aChiem85/TPR-FIles/Martin/TPR/Sensor Test Data/Sensor Data Screenshots/car present graph2.JPG

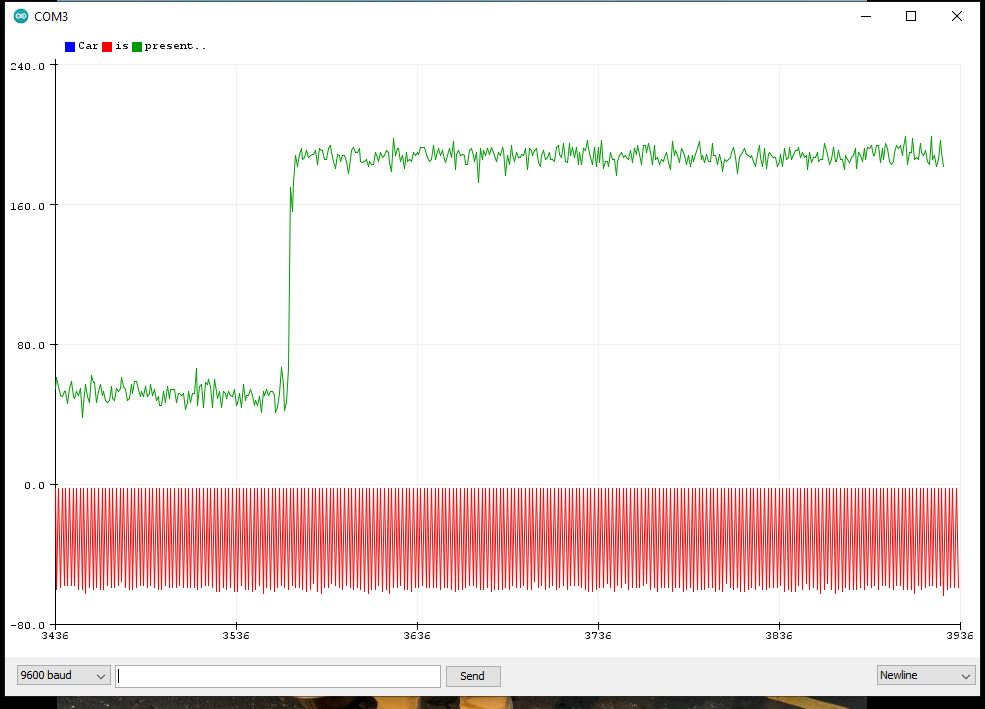
Martin/TPR/Sensor Test Data/Sensor Data Screenshots/car present graph2.JPG
