aChiem85/TPR-FIles/Martin/TPR/Sensor Test Data/Sensor Data Screenshots/car driving in and out.JPG

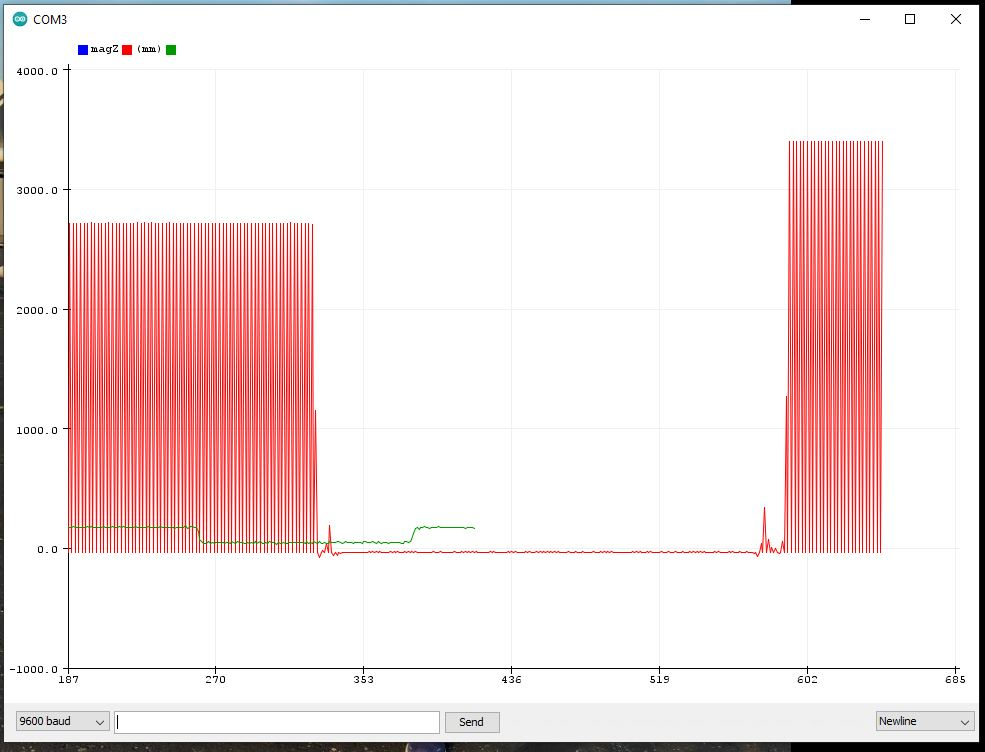
Martin/TPR/Sensor Test Data/Sensor Data Screenshots/car driving in and out.JPG
