aChiem85/TPR-FIles/README.md

# TPR-Files
Senior Design 2 Team Peer Review Files
This is where all documents used for our Senior Design reside.
For all documents dating after the TPR it is in the After TPR Files Directory.
https://github.com/aChiem85/After-TPR-Files
