aChiem85/TPR-FIles/Avery/Research (Technical Journal)/Senior design Arduino config.docx

Senior design Arduino config (Live mobile email dump)

Low power programs

https://www.arduino.cc/en/Reference/ArduinoLowPower

Power supply

https://support.arduino.cc/hc/en-us/articles/360014653660-What-type-of-power-supply-should-I-use-with-my-Arduino-MKR-board-

Support batteries for future application

https://store-usa.arduino.cc/products/arduino-mkr-wan-1310?selectedStore=us

Getting started

https://www.arduino.cc/en/Guide/MKRWAN1310

https://media.digikey.com/pdf/Data%20Sheets/Arduino%20PDFs/ABX00017_1-10-18.pdf

Lora antenna

https://content.arduino.cc/assets/mkrwan1310-murata_lora_module-type_abz.pdf

Sending signal

https://how2electronics.com/sending-sensor-data-lora-sx1278-arduino/

IoT- internet of things


Sent from my iPhone
