aChiem85/TPR-FIles/Midterm Presentation Content.docx

Presentation Content

1. What kind of sensors and electrical components are we going to use and why? (How will it be configured, maybe include price of components?)
2. How will our sensors and hardware work to collect and send data? (what kind of data will the sensors send… unique identifier, Boolean logic for parking stall status, etc.)
3. What is the amount of power consumed by our sensors in accordance with time?
4. How do we plan to power our sensors (battery + solar panel, longevity of charge)?
5. Specifications of electrical equipment such as temperature ranges, detection ranges, transmission ranges, signal speed. (This is a hard bullet to answer as we have not begin testing our equipment)
6. LoRa specification compliance (V1.1 Lora alliance OTAA) provided by coach Allen as a requirement to have information on.
7. How do we plan to mitigate extreme weather and poor conditions such as oil build up, false detection from other metal objects (under ground installation, insulated housing for electrical equipment, NEMA rating needed to satisfy sensor protection, minimum detection time of ferrous object to send signal)
8. Future scope of project and concerns such as mass installation of sensors and easy maintenance or replacement. (this last bullet can be removed as the 7th bullet has lots of content and we may not be able to actually speak to the long term based off of our research this far)

Midterm Presentation and Requirements Review, Conducted Week 7-8: Each team member will be required to equally contribute to the presentation, clearly define their personal contributions towards requirements research, and address questions asked during the review*. The presentation is a summary of the findings

based on the project research conducted. An individual grade is assigned based upon the student’s contribution to the project and oral presentation skills. Each team member is required to present their own research efforts. Each team is required to produce a PowerPoint presentation to clearly and concisely present their requirements research to the class.

The presentation slides will be graded according to the following Rubric:

· Identifies Team Members, Team Structure, Disciplines, and Roles (10%)

· Content Clarity of Presentation Material (organized, summarizes findings) (20%)

· Participation Time of each Presenter (roughly equal) (10%)

The oral presentation will be graded according to the following Rubric:

· Presentation Clarity (simple language, easy to follow narrative) (20%)

· Personal Contributions Identified (and purpose of activity) (20%)

· Presentation Delivery (eye contact, gestures, practiced) (20%)

*Please note: All team members shall be present at midterm presentations
