aChiem85/TPR-FIles/Max/SDP1_BlockDiagram.docx

User Interface (work in progress)

Smart Park Sensor

Battery

Time of Flight Sensor

Magnetometer

Arduino Unit
