aChiem85/TPR-FIles/Alex/Researching Docs/10_08_2021 Researching.odt

Start 12:59 @ 10/08/2021

After the presentation, some things were asked from the instructor:

Power issues

(May be more of a need to get it running basis to know)

Hardware going haywire

(This may be a software thing where conditions can be added)

Sensor(s) performance

(Mentioned the ToF accuracy chart, but was only able to give him an anecdote on the magnetometer’s detection range)

Vehicle Outliers

(We’ve had thoughts on it, but not prepared to answer that yet)

Sensor Spamming

(This may be a conditional thing we can write in the software)

Someone to get in touch for Service Learning: WSU PD

Reasoning

(This could be for handicap spots and be used as a traffic counter. While I still can’t comprehend the traffic counter, I’m sure if I heard it again it would sit better in my mind.)

Reasoning for the group

This could help drop the difficulty a bit and really concentrate on the basics of the hardware package and the software not needing to create more conditions for more outlier situations.

The traffic counter could be a good start use in terms of testing the send/receive frequency and this would test the power consumption of the package rather than the power needed for sending/receiving the payload instead.

END 13:17
