aChiem85/TPR-FIles/Alex/Researching Docs/10_28_2021 Researching.odt

Start 10/28/2021 @ 22:30

Received the Time of Flight Sensor and started to mess with it a bit and various clear covers. It looks like we need to start a calibration to offset the material used. It also wanted very specific requirements. The requirements are:

- A clear cover (glass or plastic is fine, but is more ideal if it didn’t ‘change’).
- The air gap can be 0.5mm AT MOST.
- The cover MUST be parallel to the sensor

It does have it’s own calibration whenever it it power cycles without any additional programming, but it seems we may need to look a bit more deep into starting the calibration to ensure it is reading properly. While I’ve tested both plastic and glass, I do not have a piece of plastic that meets the airgap requirements, but I did manage to find a small piece of clear glass for smartphone cameras and was able to confirm that it does indeed work as intended, but there is some signal loss (mainly losing distance fidelity). The fidelity lost doesn’t seem too much of a drop, as it can still read a white piece of paper pointing at a popcorn ceiling reliably at 30 inches, but gets a bit noisy beyond 30 inches and loses ‘sight’ and very noisy at 40 inches.

END 23:10
