aChiem85/TPR-FIles/Alex/Researching Docs/9_19_2021 Researching.docx

START
Sunday 9/19/2021 @ 10:30AM

Infrared Sensors for Parking

Reference on differing types (Magnetometer, IR, ultrasonic, and radar)

https://hk.element14.com/smart-parking-solutions-the-iot-sensors-space-race

https://ops.fhwa.dot.gov/publications/fhwahop06006/chapter_6.htm

Since we are going for magnetometer

Sensor I found is

# TLV493DA1B6HTSA2

DATASHEET

https://media.digikey.com/pdf/Data%20Sheets/Infineon%20PDFs/TLV493D-A1B6_Rev1.1_4-9-19.pdf

Infineon 3 axis sensor

https://www.digikey.com/en/products/detail/infineon-technologies/TLV493DA1B6HTSA2/5891933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

Pricing tier

1 for $2.11

1000 for $0.88/per

To make it match up

# KITXMC2GOXMC1100V1TOBO1

Infineon dev board with XMC1100 chip on board (recommended in their datasheet)

https://www.digikey.com/en/products/detail/infineon-technologies/KITXMC2GOXMC1100V1TOBO1/4832815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

1 for $6.38

This uses UART communications

UART, or universal asynchronous receiver-transmitter

Make sure ALL components can take the weather swings

Looked into a RAK4200 eval board and breakout board
-40C = -40F

105C = 221F

https://www.thethingsnetwork.org/docs/lorawan/frequencies-by-country/

Need to make sure that we are getting the right frequencies for the US

United States of America (USA) | US902-928

Used in USA, Canada and South America

Uplink:

1. 903.9 - SF7BW125 to SF10BW125
2. 904.1 - SF7BW125 to SF10BW125
3. 904.3 - SF7BW125 to SF10BW125
4. 904.5 - SF7BW125 to SF10BW125
5. 904.7 - SF7BW125 to SF10BW125
6. 904.9 - SF7BW125 to SF10BW125
7. 905.1 - SF7BW125 to SF10BW125
8. 905.3 - SF7BW125 to SF10BW125
9. 904.6 - SF8BW500

Downlink:

1. 923.3 - SF7BW500 to SF12BW500 (RX1)
2. 923.9 - SF7BW500 to SF12BW500 (RX1)
3. 924.5 - SF7BW500 to SF12BW500 (RX1)
4. 925.1 - SF7BW500 to SF12BW500 (RX1)
5. 925.7 - SF7BW500 to SF12BW500 (RX1)
6. 926.3 - SF7BW500 to SF12BW500 (RX1)
7. 926.9 - SF7BW500 to SF12BW500 (RX1)
8. 927.5 - SF7BW500 to SF12BW500 (RX1)
9. 923.3 - SF12BW500 (RX2)

https://www.thethingsnetwork.org/docs/lorawan/limitations/

Need to understand any limitations with LoRa WAN that COULD make it a bit more cumbersome (like the not-real-time data).

Question now: Is purchasing a ‘pre made’ package a good idea? This will probably depend on the CS team in how they want to manage the app and data.

How the duty cycle will affect our sending/receiving to/from sensors to server.

https://www.thethingsnetwork.org/docs/lorawan/duty-cycle/

Modulation and Data Rate

https://www.thethingsnetwork.org/docs/lorawan/modulation-data-rate/

Glance thought: Having these modules on the light posts to mitigate time loss, data/package loss, and the ability to send more data, and use less power on each LoRa WAN module.

LoRa WAN Modules

https://www.google.com/search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

END

Sunday 9/19/2021 11:59am
