aChiem85/TPR-FIles/Alex/ToF Sensor/Window Recommendations.JPG

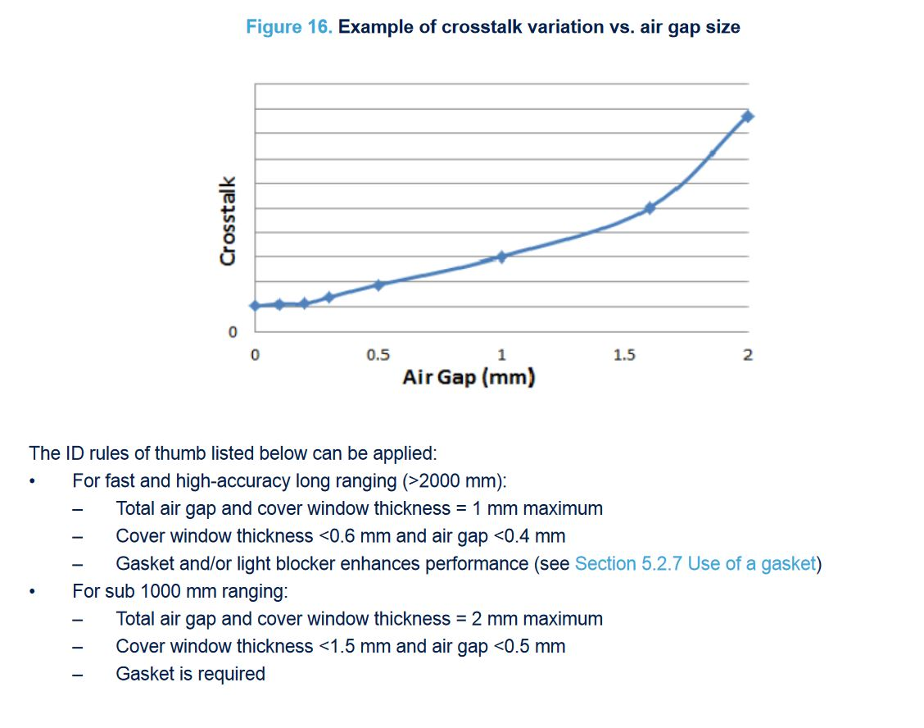
Alex/ToF Sensor/Window Recommendations.JPG
