aChiem85/TPR-FIles/Martin/Sensor Package Verification Workflow.xlsx

Type of sensor | Model Number | Determine Type of Sensing | Composition of Target | Distance to Target Object | Sensor Size/Shape | Control Interface | Wiring Type | Cost | Special Requirements
Magnetometer | HMC5883L | Presence of Vehicle | Ferromagnetic
