aChiem85/TPR-FIles/Avery/Orders/Reimbursement Request.xlsx

 | ECE and SoC Senior Design Reimbursement Form.
STUDENT: myWSUID: Has received approval for the below purchases and should be reimbursed by ECE/SoC accordingly.
PURCHASE DATE | VENDOR | ITEM | TOTAL $
 |  |  | $0.00
 |  |  | $0.00
 |  |  | $0.00
 |  |  | $0.00
 |  |  | $0.00
 |  |  | $0.00
 |  |  | $0.00
 |  |  | $0.00
 |  |  | $0.00
 |  |  | $0.00
 |  |  | $0.00
 |  |  | $0.00
 |  |  | $0.00
 |  |  | $0.00
 | Total expenses for reimbursement: $ |  | $0.00
Students Signature:
Authorized Signature: |  | Date:
 | ECE/SoC Senior Design Instructor
