aChiem85/TPR-FIles/Martin/TPR/Sensor Test Data/Sensor Data analysis figures/different car scenarios.JPG

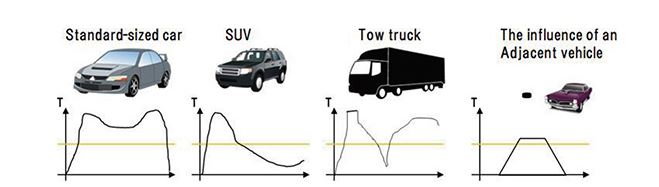
Martin/TPR/Sensor Test Data/Sensor Data analysis figures/different car scenarios.JPG
