aChiem85/TPR-FIles/Martin/TPR/Sensor Test Data/Sensor Data analysis figures/engine effect.JPG

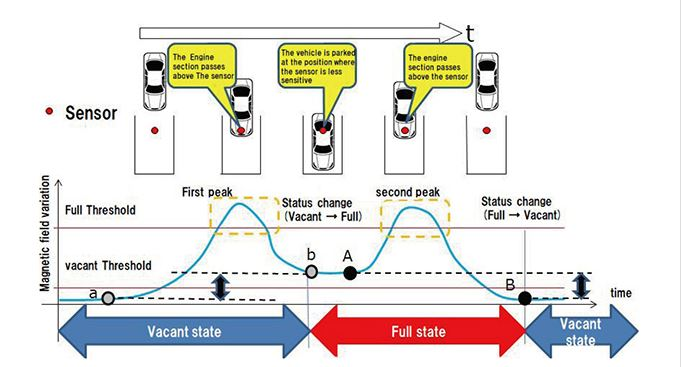
Martin/TPR/Sensor Test Data/Sensor Data analysis figures/engine effect.JPG
