aChiem85/TPR-FIles/Martin/TPR/Sensor Test Data/Sensor Data analysis figures/position relative to car.JPG

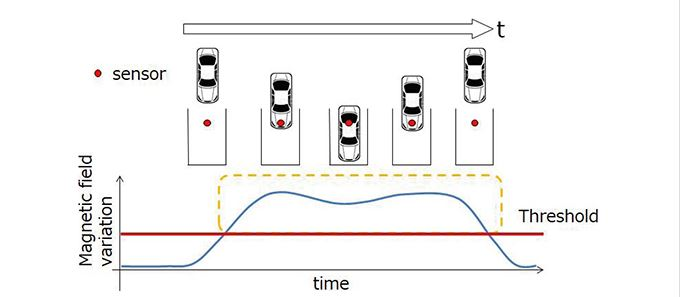
Martin/TPR/Sensor Test Data/Sensor Data analysis figures/position relative to car.JPG
