aChiem85/TPR-FIles/Martin/TPR/Sensor Test Data/Sensor Data analysis figures/reversing state.JPG

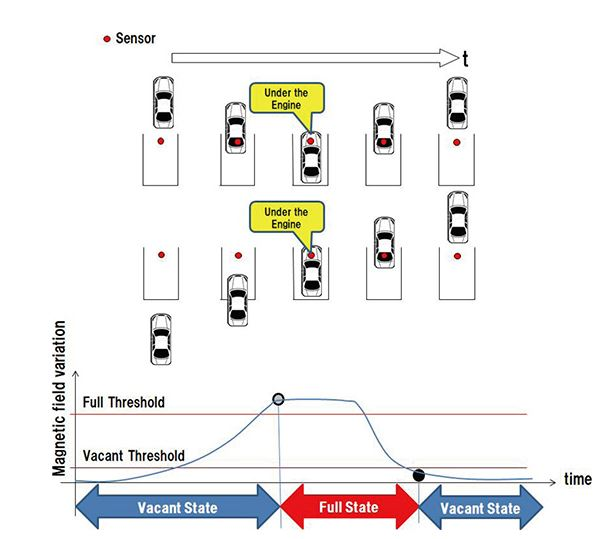
Martin/TPR/Sensor Test Data/Sensor Data analysis figures/reversing state.JPG
