aChiem85/TPR-FIles/Martin/TPR/Sensor Test Data/Sensor Data Screenshots/car might be there data.JPG

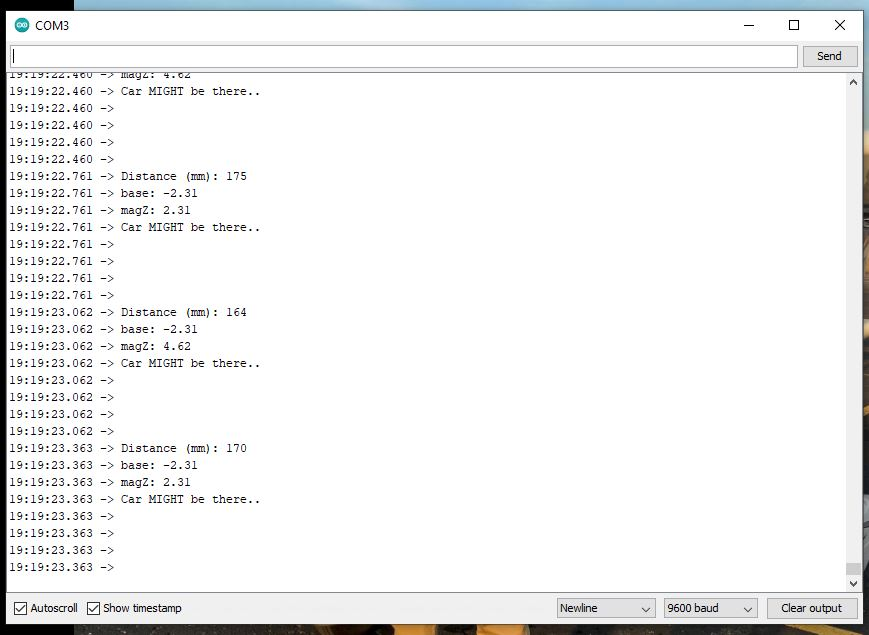
Martin/TPR/Sensor Test Data/Sensor Data Screenshots/car might be there data.JPG
