aChiem85/TPR-FIles/Martin/TPR/Sensor Test Data/Sensor Data Screenshots/car not present graph.JPG

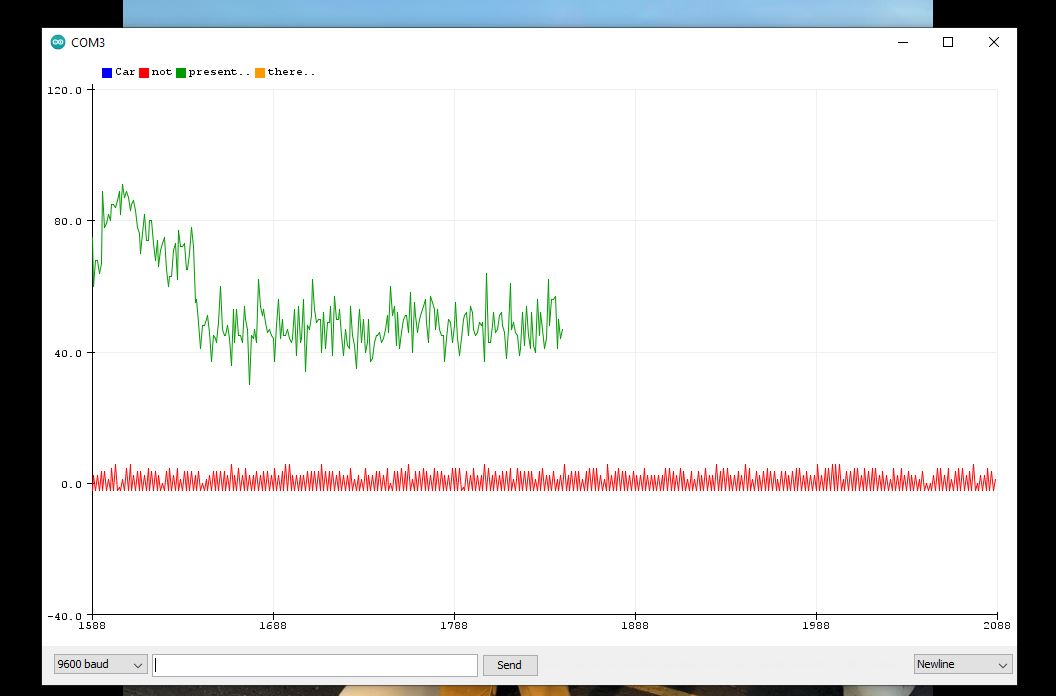
Martin/TPR/Sensor Test Data/Sensor Data Screenshots/car not present graph.JPG
