aChiem85/TPR-FIles/Martin/TPR/Sensor Test Data/Sensor Data Screenshots/car present data.JPG

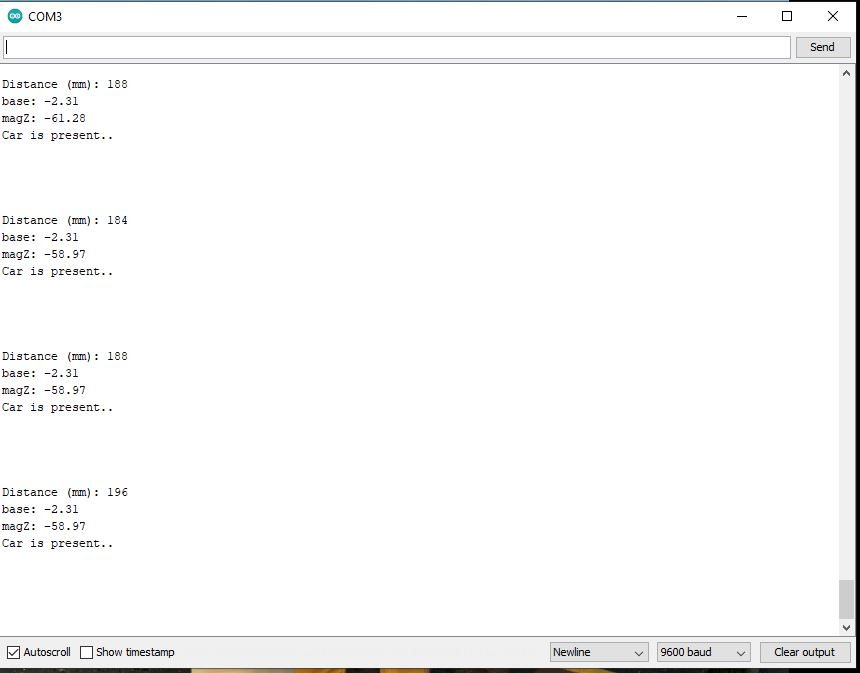
Martin/TPR/Sensor Test Data/Sensor Data Screenshots/car present data.JPG
