aChiem85/TPR-FIles/Martin/TPR/Sensor Test Data/Sensor Data Screenshots/car present graph3.JPG

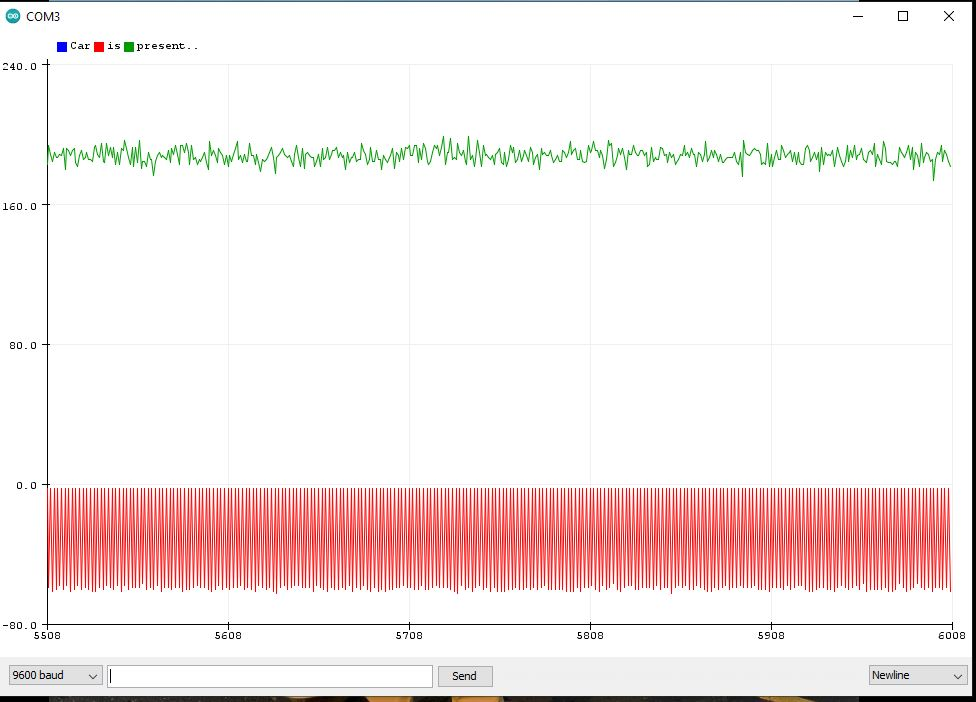
Martin/TPR/Sensor Test Data/Sensor Data Screenshots/car present graph3.JPG
