aChiem85/TPR-FIles/Martin/TPR/Sensor Test Data/Sensor Data Screenshots/car present graph.JPG

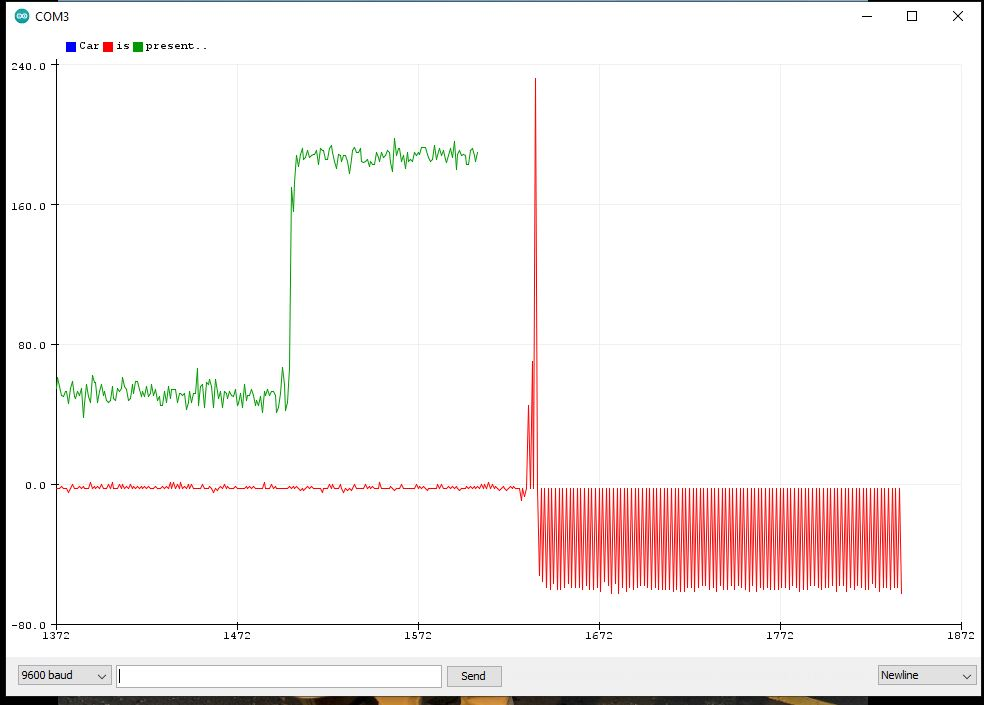
Martin/TPR/Sensor Test Data/Sensor Data Screenshots/car present graph.JPG
