aChiem85/TPR-FIles/Martin/TPR/Sensor Test Data/Sensor Data Screenshots/car presnt with time stamps.JPG

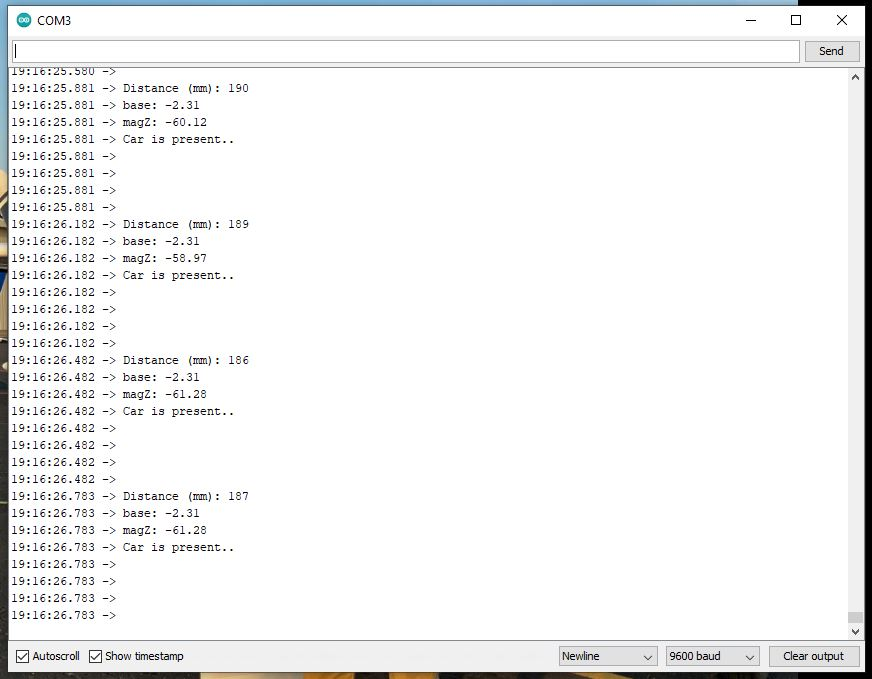
Martin/TPR/Sensor Test Data/Sensor Data Screenshots/car presnt with time stamps.JPG
