aChiem85/TPR-FIles/Martin/TPR/Sensor Test Data/Sensor Data Screenshots/raw data car presentJPG.JPG

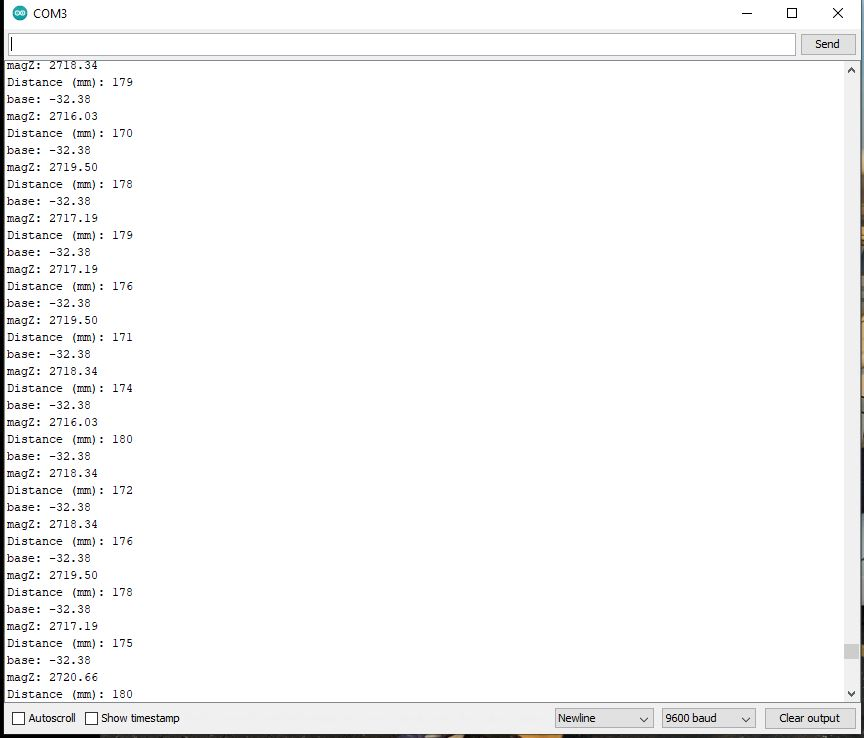
Martin/TPR/Sensor Test Data/Sensor Data Screenshots/raw data car presentJPG.JPG
