aChiem85/TPR-FIles/Avery/Research (Technical Journal)/Sensors.docx

Sensors:

Hiletgo MPU9250 9-Axis 9 DOF 16 Bit Gyroscope/Accelerometer:

Amazon.com: HiLetgo MPU9250 9-Axis 9 DOF 16 Bit Gyroscope Acceleration Magnetic Sensor 9-Axis Attitude +Gyro+Accelerator+Magnetometer Sensor Module IIC/SPI for Arduino GY-9250 : Industrial & Scientific (https://www.amazon.com/dp/B01I1J0Z7Y)

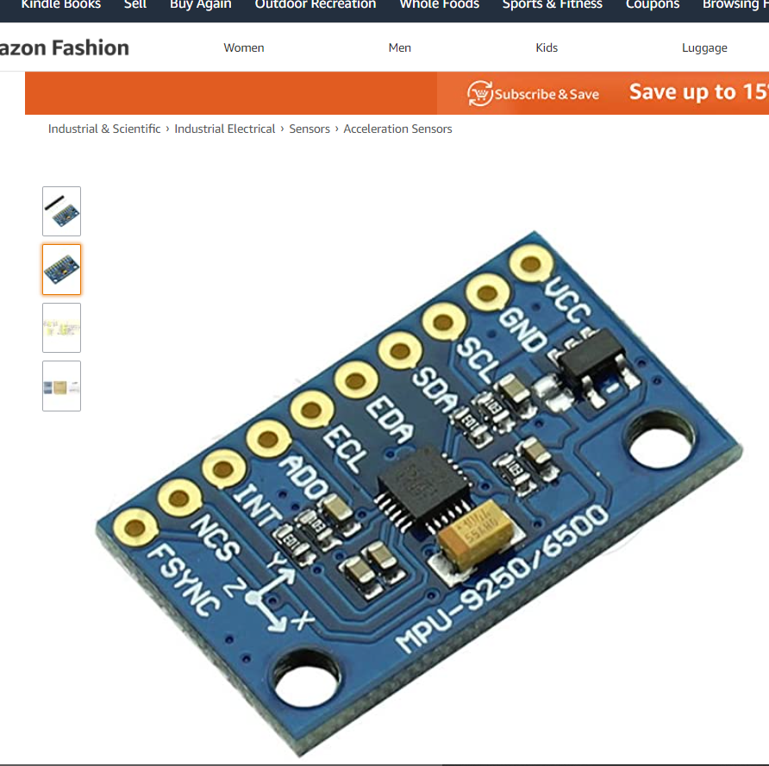
[picture p37: figure]

This is the magnetometer sensor we currently have.

Notes:

This sensor is a magnetometer, accelerometer, and gyroscope. However so far only the magnetometer functionality has been of use. May look into only getting magnetometer for cheaper price if accelerometer is of no use. Gyroscope will be of no use going forward.

Cheaper 3 axis magnetometer only:

Amazon.com: ACEIRMC 5pcs GY-273 QMC5883L 3-Axis Compass Magnetometer Sensor Board Module IIC/I2C for Arduino 3-5V Power High Accurancy : Electronics (https://www.amazon.com/ACEIRMC-QMC5883L-Compass-Magnetometer-Accurancy/dp/B08T239MLY)

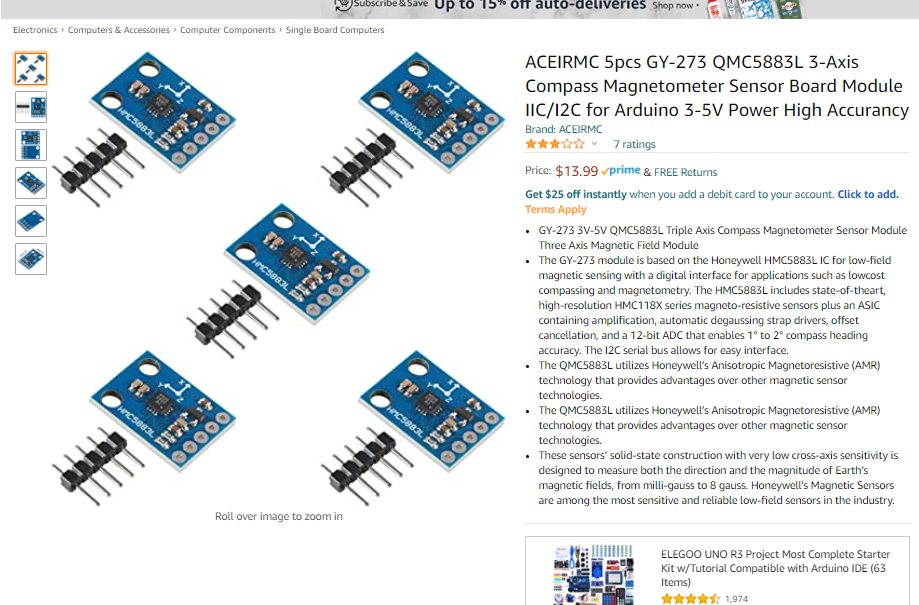
[picture p38: figure]

Note: Cheaper packaging only includes magnetometer. This option can read magnetic changes through objects making an ideal option because exposure is not required. We need to be able to protect sensor packaging from debris.

Time of flight sensor Vl53l0X:

Amazon.com: Adafruit (PID 3317) VL53L0X Time of Flight Distance Sensor - ~30 to 1000mm : Electronics (https://www.amazon.com/Adafruit-VL53L0X-Flight-Distance-Sensor/dp/B01MTSVU1E?qsid=138-1350617-2163110)

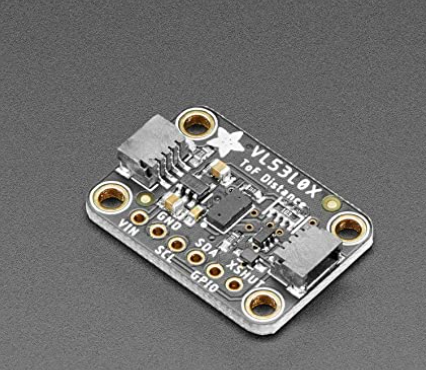
[picture p39: figure]

Note: So far this sensor has been very useful. It requires line of sight so our sensor packaging must have either a clear window or full exposure. Could be a less durable option as debris could significantly effect readings.

Enclosure:
