aChiem85/TPR-FIles/Alex/Journals/Chiem/09_12 Journal.docx

What is the problem, Why that is a problem, How are your planning on solving, or How you solved it.

Due Sunday 9/12/2021

Class Week 4

Journal Week 1

Current Problem:

Currently, we are a team of 4 (primarily EE’s) and there is also another team of 5 (CS’s) that are doing the smart parking. Depending if the 5 CS’s wants to join and make a larger group of 9 to do this project will determine the complexity of the project.

Solution:

I have only heard that the CS team is talking to see if the route of 9 is something they want, otherwise we’ll most likely continue with the same smart parking with the 4 EE’s we have, but will most likely tone down the software part.
