aChiem85/TPR-FIles/Alex/Journals/Chiem/Block Diagram.pdf

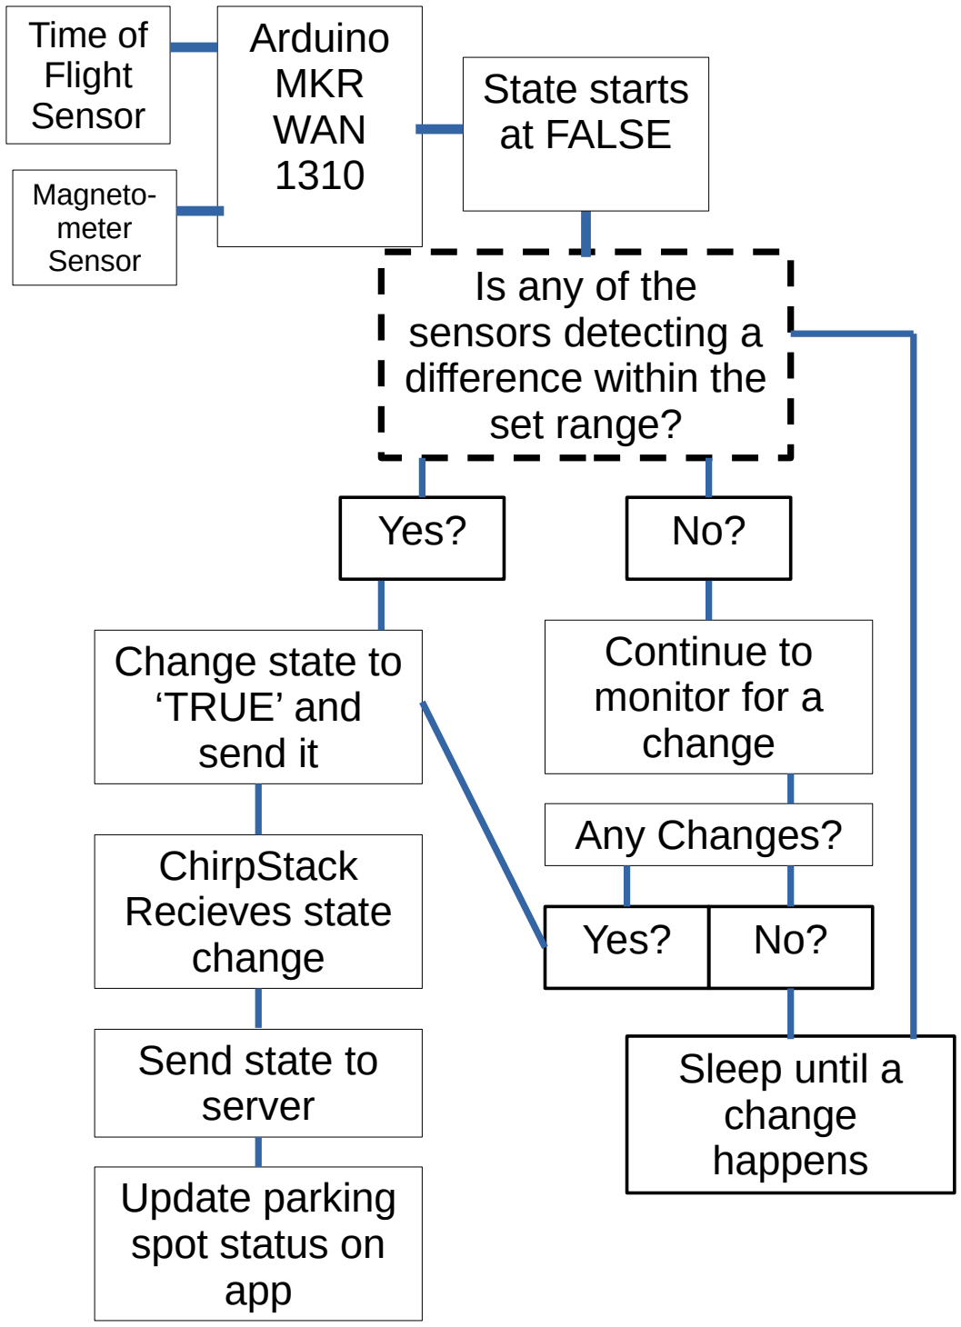
[picture p45: figure]
Time of Flight Sensor; Magneto- meter; Sensor; Is any of the; sensors detecting a difference within the set range?; Yes?; Arduino MKR WAN 1310; Change state to ‘TRUE’ and send it; Continue to monitor for a change; Any Changes?; Sleep until a change happens; ChirpStack Recieves state change; Send state to server; Update parking spot status on app; State starts at FALSE

Scenario: Car takes open parking spot

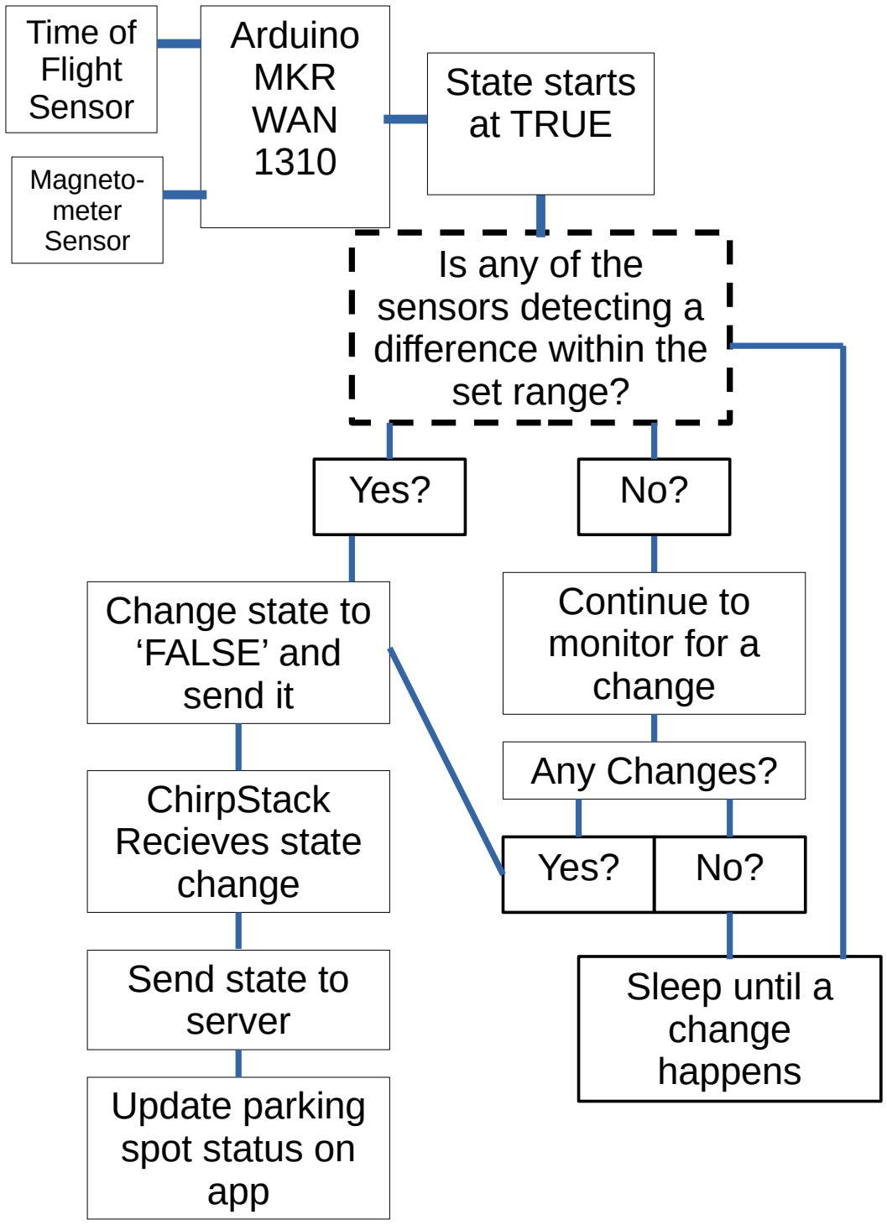
[picture p46: figure]
Time of Flight Sensor; Magneto- meter; Sensor; Is any of the; sensors detecting a difference within the set range?; Yes?; Arduino MKR WAN 1310; Change state to ‘FALSE’ and send it; Continue to monitor for a change; Any Changes?; Sleep until a change happens; ChirpStack Recieves state change; Send state to server; Update parking spot status on app; State starts at TRUE

Scenario: Car leaves parking spot
