aChiem85/TPR-FIles/Max/SPD1_JournalEntry2.docx

Team Name: Collaboration Team

09/12/2021: Individual Journal

Maximillian Burrell

Z749D638

Week of Sept 20th

Product Title: “Smart Park System”

Update:

The group has concluded that we build a version using magnetometers. There may be some induction loop applications, much like traffic light technology. However, our group faced a problem. A product similar to our idea exists. The goal at this point is to make improvements and to study the other products that are supposed to do the same thing as ours. The good news is that the idea has not been utilized in some areas of interests that we had in mind. For example, there does not seem to be universities that have the smart park system utilized. I can testify that this is a great opportunity to capitalize our product with those areas of interest, such as our own university and nearby ones. I have volunteered for parking lot detail for the university’s basketball games (when I was still an Army ROTC cadet before I got kicked out and faced other issues during the Spring 2021). That job is a nightmare to organize effectively, especially when events are close to beginning which is when the traffic congestion is usually at it’s worst.

Application:

We began collaborating with the other group, with the computer science element of the project, and we also began research. My team has began gathering the electronic components to start physically building a prototype. Thereafter, we have plans for the other group to write programs to start its functionality. However, it will not be guaranteed that we succeed. I will contribute more than likely with the computer science functions instead of the physical build. I work a full time job at the Kansas Star Casino during the evening, five days a week. The teams know this, as I’ve expressed my schedule to them. Nonetheless, we’ll all have something to do. We all have each other’s information to communicate and to pass along our work for the assembly process.

Goal of the Week and Potential Problems:

The goal now is to start trying to piece the system together. We have began gathering our resources to try and check it out (prototype). I personally believe we can refine and improve existing products from other organizations. I’m only concerned about potential patent rights and copyright claims. We’ll all figure that out eventually.
